snckwf/home-assistant-button-esp8266-esphome/images/cover-home-assistant-button.png

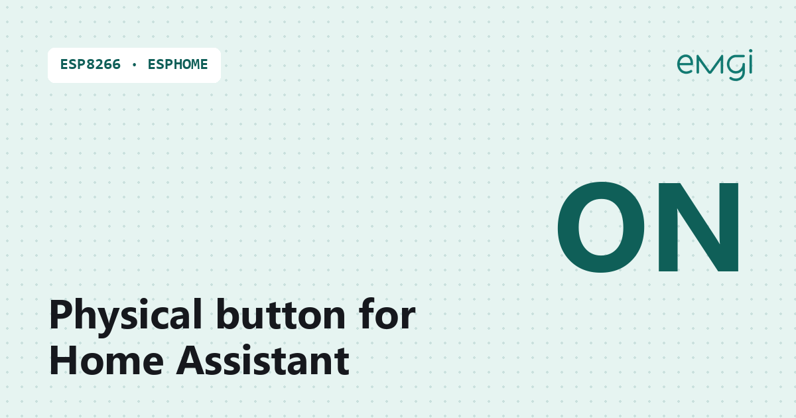
images/cover-home-assistant-button.png
