snckwf/home-assistant-button-esp8266-esphome/case_3d/ha_button_shell.stl

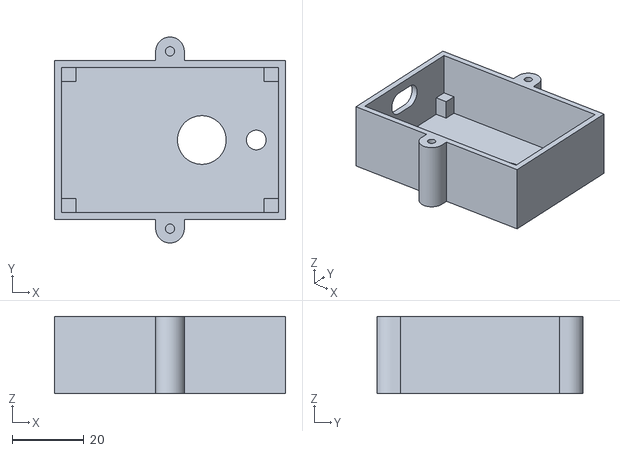
[picture p6: CAD file, 2026-10-11]
case_3d/ha_button_shell.stl
64.6 x 57.6 x 21.6
