snckwf/home-assistant-button-esp8266-esphome/case_3d/ha_button_base.stl

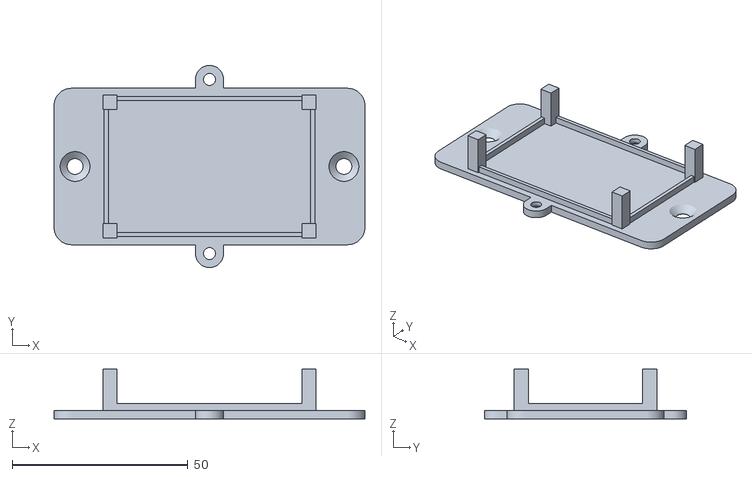
[picture p7: CAD file, 2026-10-11]
case_3d/ha_button_base.stl
88.6 x 57.6 x 14.2
