snckwf/home-assistant-button-esp8266-esphome/(commit log)

2026-10-11 Pulsante fisico per Home Assistant con ESP8266, ESPHome, LED di stato e case stampato in 3D
    Articolo: https://www.emgi.it/2026/10/03/pulsante-fisico-home-assistant-esp8266-esphome-led-case-3d/
    Claude-Session: https://claude.ai/code/session_01BdDk9w7oC75ueusgAfLjj3
    [fondo_pulsante_ha.stl, scocca_pulsante_ha.stl]
2026-10-28 Translate the repository to English
    Code comments, on-screen and web texts, documentation, diagrams and
    images translated to English; folders and files renamed in English.
    The linked articles on www.emgi.it stay in Italian.
    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
    [ha_button_base.stl, ha_button_shell.stl]
